the-baltman/LoRa-Radio/hardware/caja/renders/01_frente_iso.png

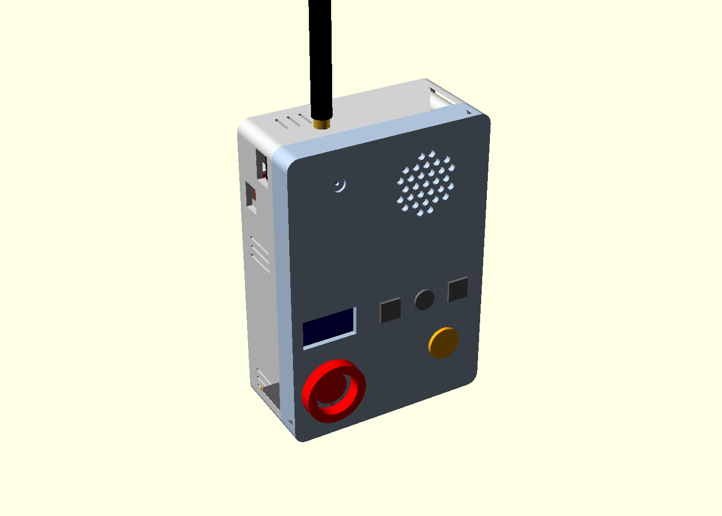
hardware/caja/renders/01_frente_iso.png
