the-baltman/LoRa-Radio/hardware/caja/renders/02_trasera_iso.png

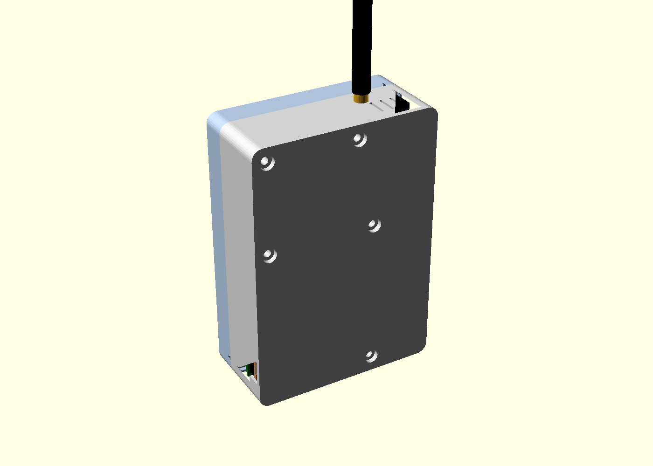
hardware/caja/renders/02_trasera_iso.png
