the-baltman/LoRa-Radio/hardware/caja/renders/04_pieza_frente_imprimir.png

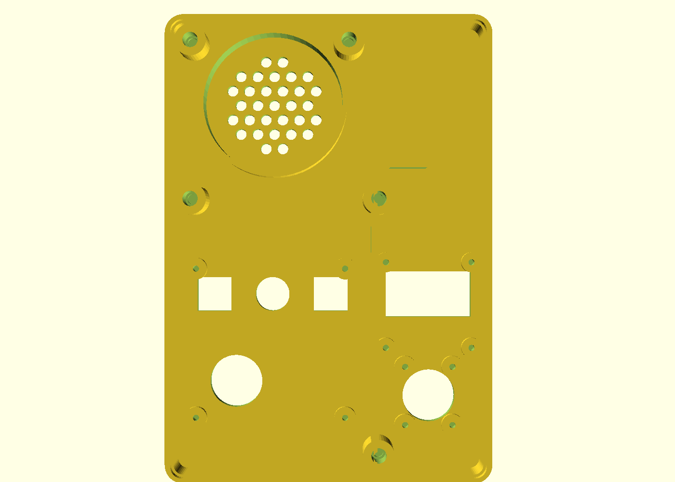
hardware/caja/renders/04_pieza_frente_imprimir.png
