the-baltman/LoRa-Radio/hardware/caja/renders/05_pieza_trasera_imprimir.png

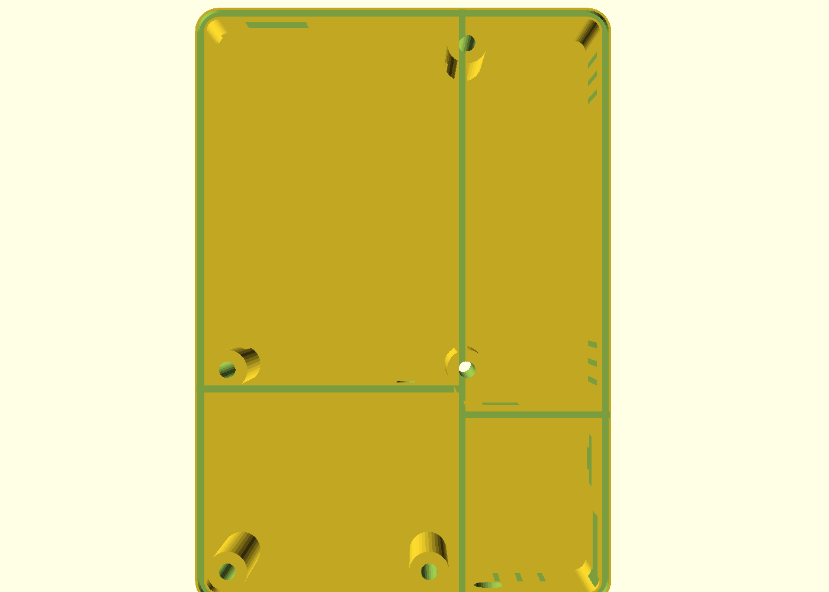
hardware/caja/renders/05_pieza_trasera_imprimir.png
