the-baltman/LoRa-Radio/hardware/caja/renders/06_corte_interior.png

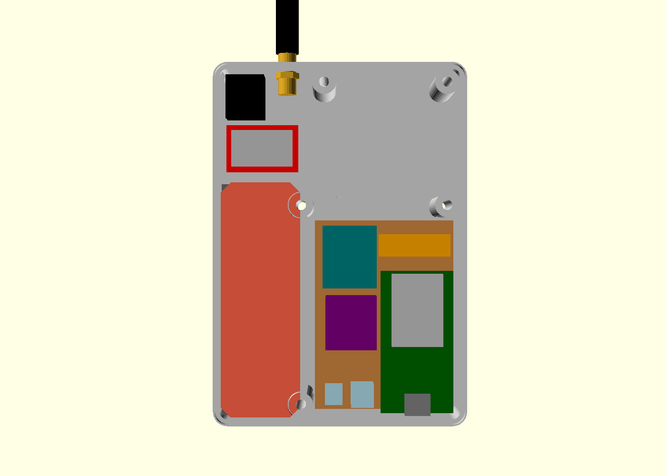
hardware/caja/renders/06_corte_interior.png
