the-baltman/LoRa-Radio/hardware/caja/renders/07_explosionado.png

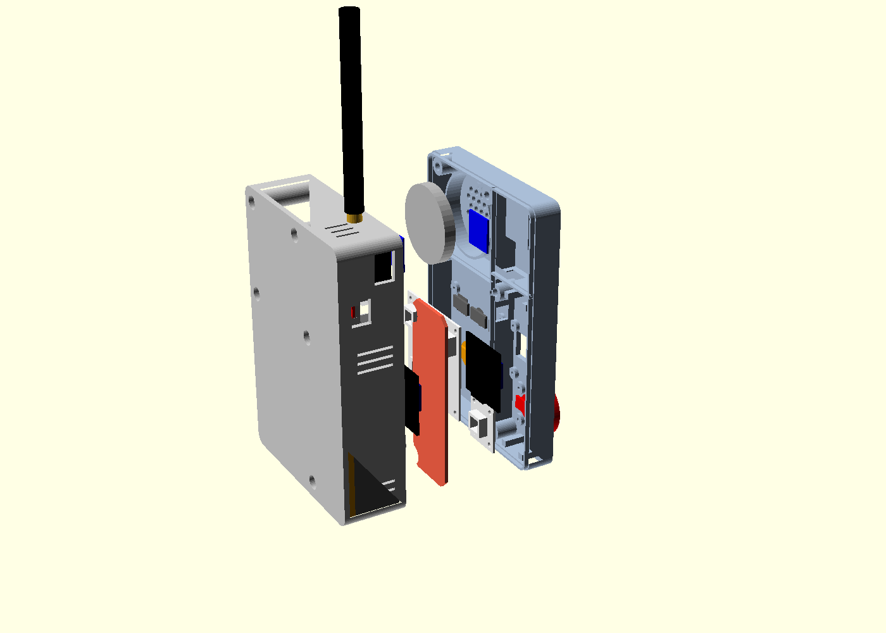
hardware/caja/renders/07_explosionado.png
