the-baltman/LoRa-Radio/hardware/caja/renders/08_trasera_transparente.png

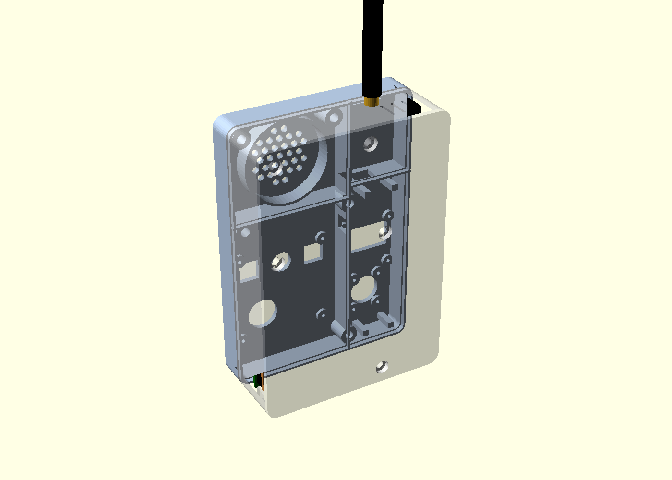
hardware/caja/renders/08_trasera_transparente.png
