the-baltman/LoRa-Radio/hardware/caja/stl/back.stl

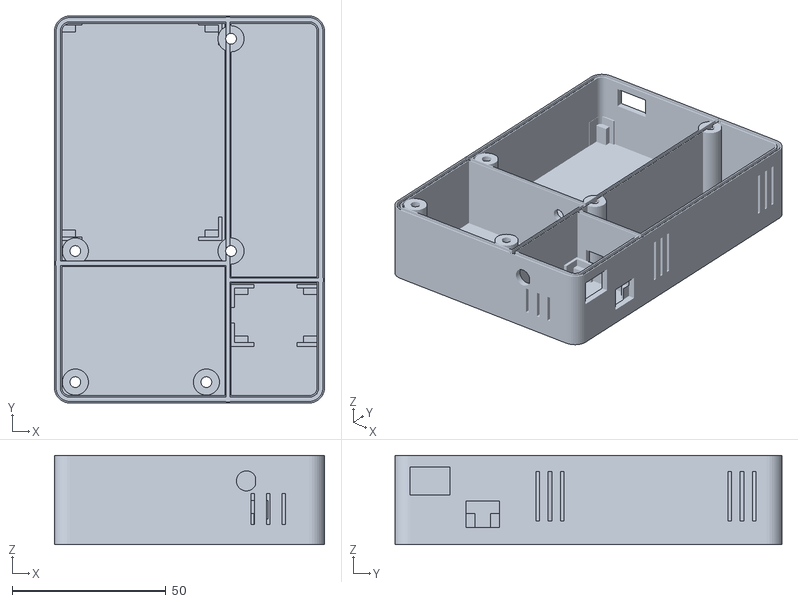
[picture p8: CAD file, 2026-10-13]
hardware/caja/stl/back.stl
87.8 x 125.8 x 29.0
