the-baltman/LoRa-Radio/hardware/caja/stl/pl_nav_rd.stl

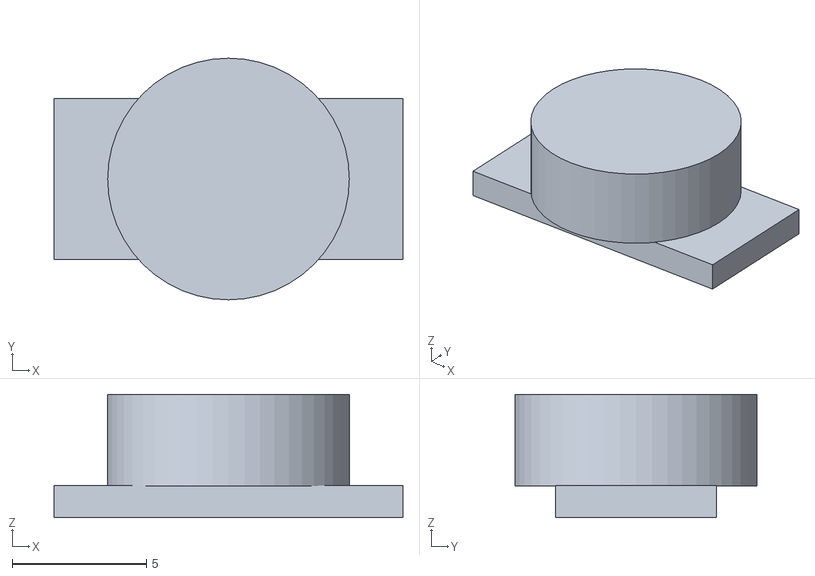
[picture p9: CAD file, 2026-10-13]
hardware/caja/stl/pl_nav_rd.stl
13.0 x 9.00 x 4.60
