the-baltman/LoRa-Radio/hardware/caja/stl/plate_sos.stl

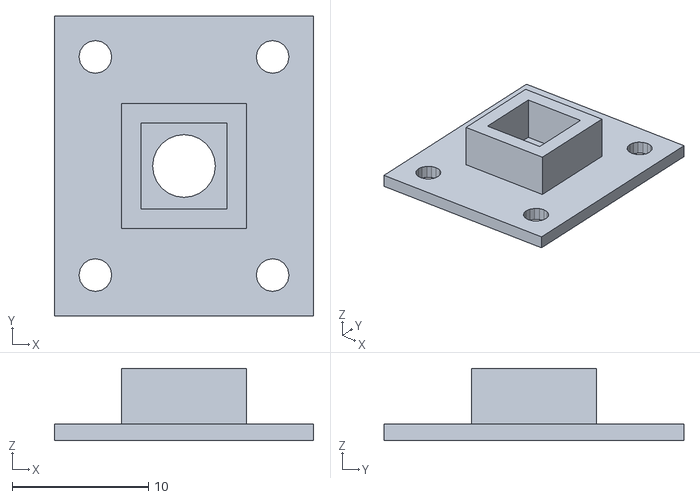
[picture p10: CAD file, 2026-10-13]
hardware/caja/stl/plate_sos.stl
19.0 x 22.0 x 5.29
