the-baltman/LoRa-Radio/hardware/caja/stl/front.stl

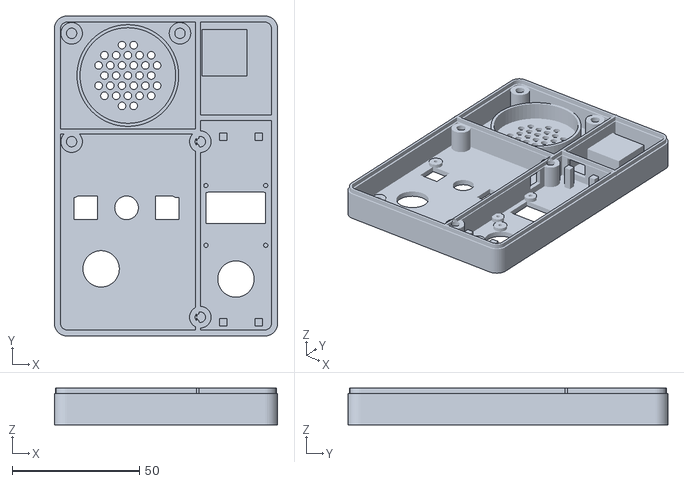
[picture p11: CAD file, 2026-10-13]
hardware/caja/stl/front.stl
87.8 x 125.8 x 14.4
