the-baltman/LoRa-Radio/hardware/caja/stl/ring_sos.stl

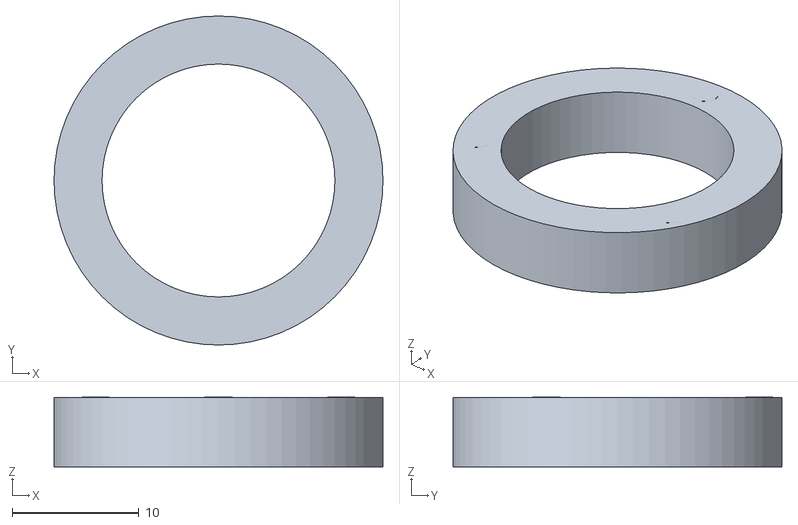
[picture p12: CAD file, 2026-10-13]
hardware/caja/stl/ring_sos.stl
26.0 x 26.0 x 5.51
