the-baltman/LoRa-Radio/hardware/caja/stl/plate_ui.stl

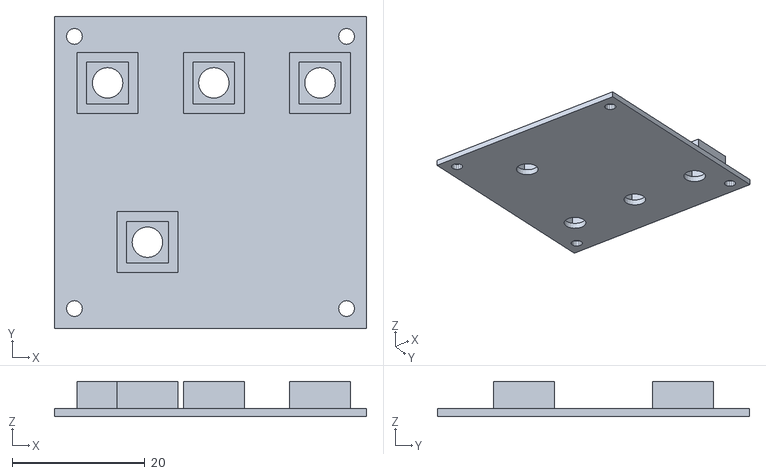
[picture p13: CAD file, 2026-10-13]
hardware/caja/stl/plate_ui.stl
47.0 x 47.0 x 5.29
