the-baltman/LoRa-Radio/hardware/caja/stl/bayplate.stl

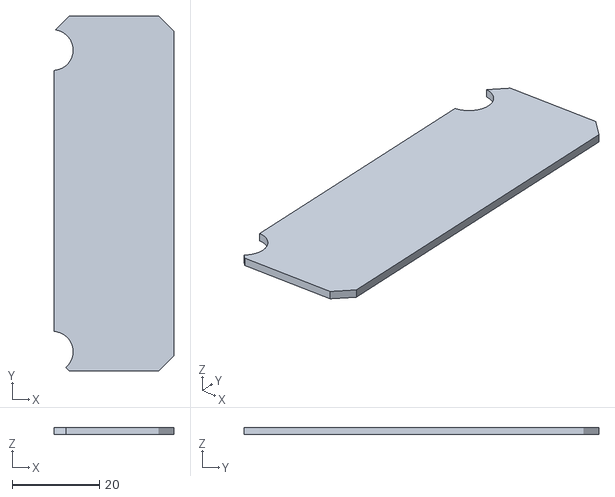
[picture p14: CAD file, 2026-10-13]
hardware/caja/stl/bayplate.stl
27.4 x 81.2 x 1.60
