the-baltman/LoRa-Radio/hardware/caja/stl/pl_sos.stl

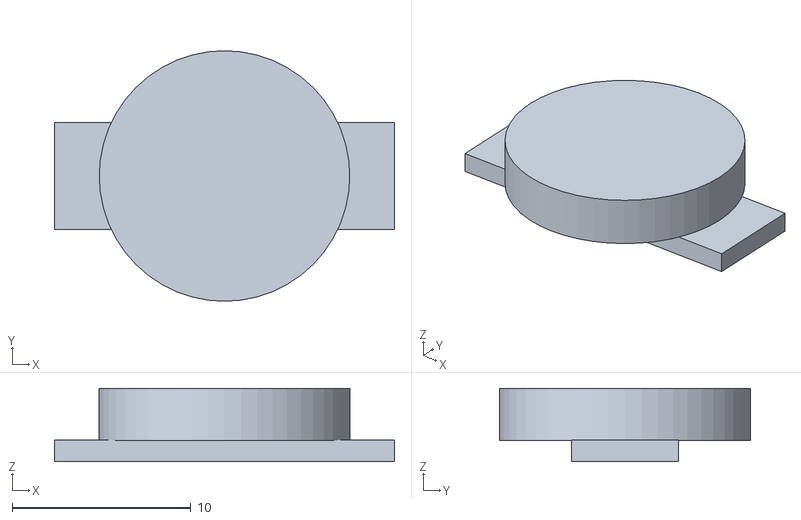
[picture p15: CAD file, 2026-10-13]
hardware/caja/stl/pl_sos.stl
19.0 x 14.0 x 4.10
