the-baltman/LoRa-Radio/hardware/caja/stl/pl_nav_sq.stl

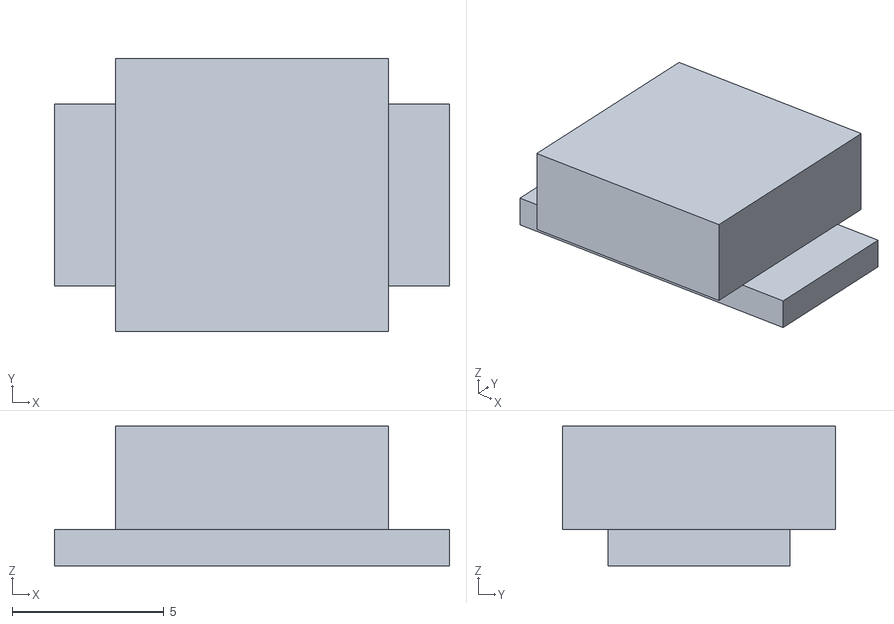
[picture p16: CAD file, 2026-10-13]
hardware/caja/stl/pl_nav_sq.stl
13.0 x 9.00 x 4.60
