the-baltman/LoRa-Radio/hardware/caja/stl/pl_ptt.stl

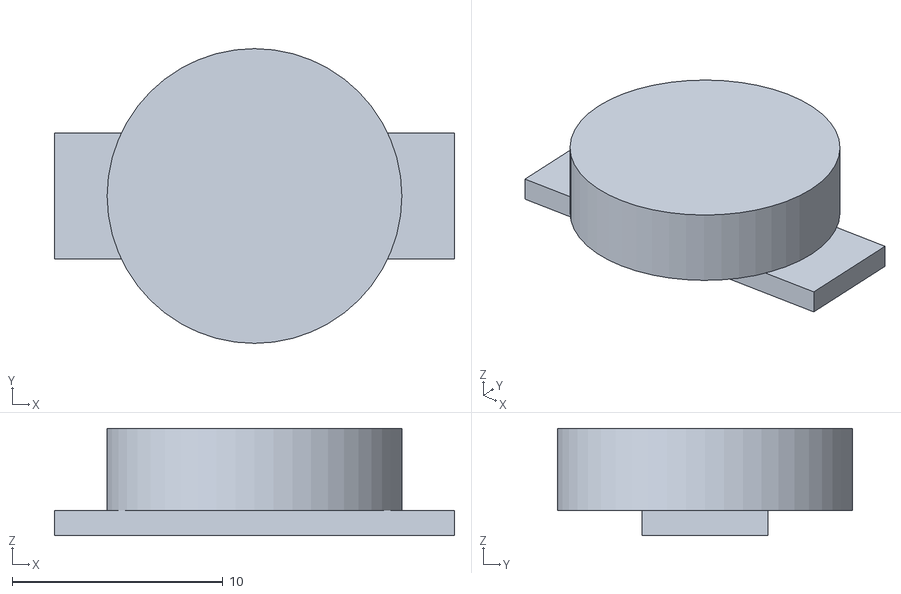
[picture p17: CAD file, 2026-10-13]
hardware/caja/stl/pl_ptt.stl
19.0 x 14.0 x 5.10
