the-baltman/LoRa-Radio/(commit log)

2026-10-02 chore: base del repo (GPL-3.0, README, script de compilacion con versiones fijas)
2026-10-02 docs: protocolo de paquetes v1 (formato, ACK, clips, negociacion de perfil, prioridad SOS)
2026-10-02 protocol: codec de paquetes, reensamblado, FSM con ACK/reintento selectivo/prioridad SOS + tests de host
2026-10-02 radio: pines/constantes y driver SX1262 (RadioLib 7.5.0, BW500 915 MHz)
2026-10-02 audio: motor I2S + Codec2 1300 (esp32_codec2 1.0.7), DSP, sirenas
2026-10-02 ui: OLED, botones con antirrebote, ADC de bateria, logica de 4 botones y bateria + tests
2026-10-02 tools: registro serie y resumen de pruebas de alcance
2026-10-02 protocol: SOS del receptor en su ranura de voz (ACK_SOS), clip max 8 s, RETRY_LISTEN 1800, barrido sweep.cpp como test
    Aplica S1-S3 del gate de c-morty. Barrido peor caso tras el ANN: 2561 ms (2 nodos), 2618 ms (3 nodos).
2026-10-02 radio: potencia 0 dBm hasta rfok, TCXO y polaridad en tiempo de ejecucion; clip max 8 s en config (gate S4)
2026-10-02 audio: buffers de 8 s, techo de volumen en NVS y tono de prueba (gate S2, S4)
2026-10-02 app: comandos serie en NVS (pot rfsw rfok tcxo cal techo tono), RF SIN VERIFICAR, gpio_hold en corte de bateria, log ACK con ms desde primer TX (gate S4, S5)
2026-10-02 protocol: el SOS pendiente del receptor nunca se pierde y backoff en reintentos (re-gate S9, S10)
    - vr_release_sos() en vr_abort y vr_close: todo cierre de la recepcion arma el SOS pendiente
    (ranura ACK_SOS, VABORT del emisor, cierre normal); plazo ACK_SOS_TIMEOUT_MS 300 tras la ranura.
    - Backoff pseudoaleatorio por nodo en los reintentos de mensaje: 0..3 ranuras de ToA_SOS + 20 ms
    (xorshift32, semilla murmur3 de id y msg_id). RETRY_LISTEN_MS 1800 -> 2650.
    - tests/host: edge.cpp (inyeccion de fallas, 28 checks) y dualsweep.cpp (dos SOS, 2 y 3 nodos,
    453 casos cada uno) en run.sh; ambos salen con codigo 1 si se rompe el limite.
2026-10-02 app: log ACK desde la pulsacion y rfsw borra rfok (re-gate S11, S12)
2026-10-13 hardware: caja rev B.2 (OpenSCAD, 10 STL, 8 renders) de mecanica, con README
    Copia identica a Mecanica\03-Disenos\LoRa-Radio-caja (scad/params por md5; STL, renders, build.sh y
    stlinfo.py byte a byte). out/ ignorado.
    [back.stl, bayplate.stl, caja_lora.scad, front.stl, params.scad, pl_nav_rd.stl, pl_nav_sq.stl, pl_ptt.stl]
2026-10-13 docs: protocolo y README con el backoff escalonado y las cifras del re-gate 3
2026-10-13 hardware: caja B.2+ (insert 6.7 mm, front.stl en build.sh, STL regeneradas)
    [back.stl, bayplate.stl, caja_lora.scad, front.stl, params.scad, pl_nav_rd.stl, plate_sos.stl, plate_ui.stl]
